team-ramrod/wackyracers/camera_hacking/python/images/test2.jpg

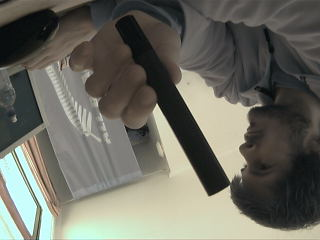
camera_hacking/python/images/test2.jpg
