team-ramrod/wackyracers/camera_hacking/python/images/tree.jpg

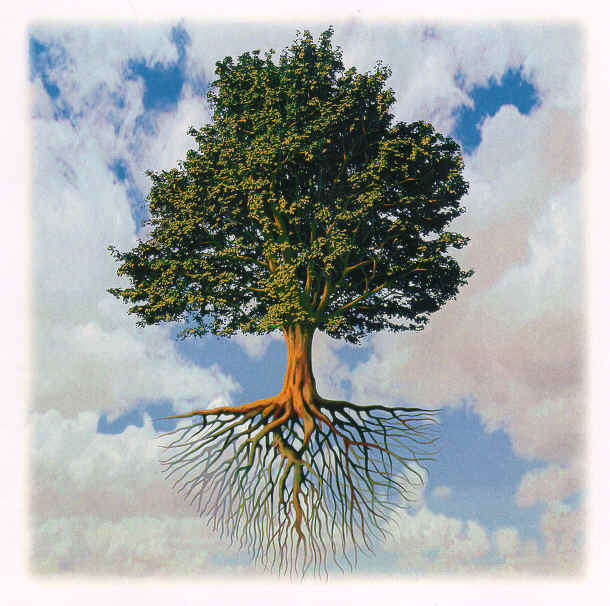
camera_hacking/python/images/tree.jpg
