team-ramrod/wackyracers/README

The preliminary assignment instructions for this assignment are to be found at 
http://ecewiki.elec.canterbury.ac.nz/mediawiki/index.php/ENEL429_project_2011
