team-ramrod/wackyracers/Altium/Perfection.png

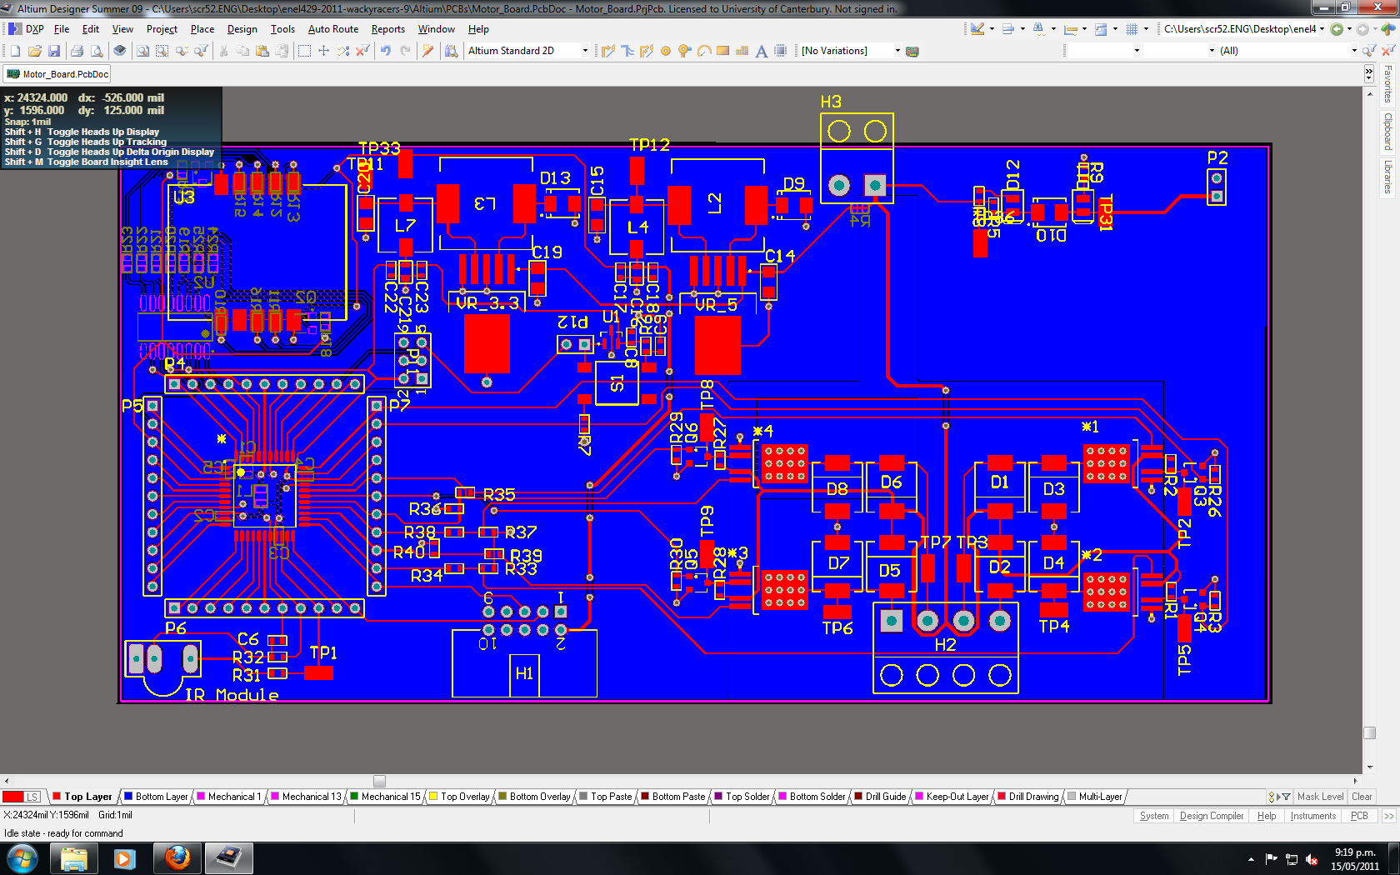
Altium/Perfection.png
