team-ramrod/wackyracers/camera_hacking/python/images/barnes.jpg

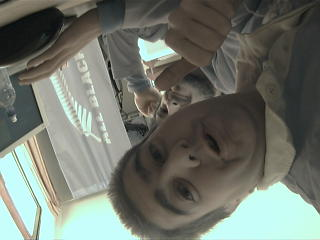
camera_hacking/python/images/barnes.jpg
