team-ramrod/wackyracers/camera_hacking/python/images/new.jpg

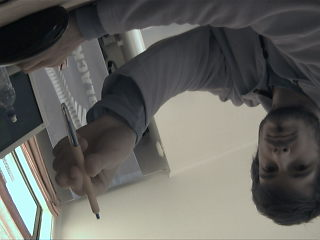
camera_hacking/python/images/new.jpg
