team-ramrod/wackyracers/camera_hacking/python/images/newtest.jpg

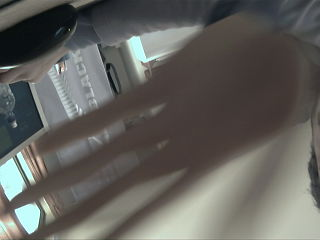
camera_hacking/python/images/newtest.jpg
