team-ramrod/wackyracers/camera_hacking/python/images/out1.jpg

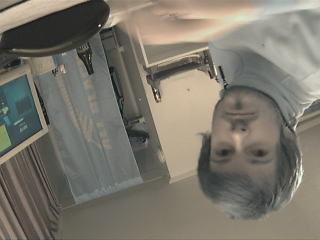
camera_hacking/python/images/out1.jpg
