team-ramrod/wackyracers/camera_hacking/python/images/out.jpg

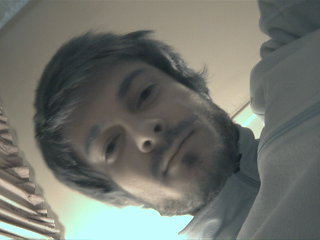
camera_hacking/python/images/out.jpg
