team-ramrod/wackyracers/camera_hacking/python/images/room.jpg

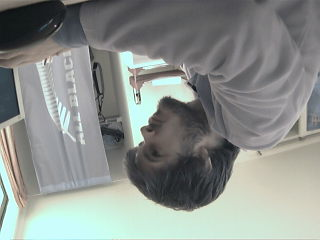
camera_hacking/python/images/room.jpg
