team-ramrod/wackyracers/docs/src/issues.tex

\documentclass[10pt]{article} 

\usepackage{hyperref}

% Muliple rows
\usepackage{multirow}

% Margins
\usepackage[margin=2.5cm]{geometry}

% Uncomment for 1 in margins
%\usepackage[in]{fullpage}

\usepackage[usenames,dvipsnames]{color}

% Font stuff
\usepackage{palatino}

\usepackage{listings}
% Code listings
\lstset{
	language=C, 
    basicstyle=\small\ttfamily,
	keywordstyle=\color{black}\bfseries,
	commentstyle=\color{OliveGreen},
}

\begin{document}
\title{Wacky Racers Issues File}
\author{Daniel Bentall et al.}
\maketitle

\section{Introduction}
This document records issues encountered during development. 

\section{Schematic Issues}
\begin{itemize}
\item The voltage pins are inconsistent and need to be checked through
\item Many non-power pins are drawn as in-out pins (which look like ----$<|>$-) when they should be in or out only
\end{itemize}

\section{PCB Issues}

\section{Software Issues}

\section{Other Issues}

\begin{itemize}
\item Wim
\end{itemize}

\end{document}
