team-ramrod/wackyracers/docs/issues.pdf

# Wacky Racers Issues File

Daniel Bentall et al.

### May 29, 2011

## 1 Introduction

This document records issues encountered during development.

## 2 Schematic Issues

- The voltage pins are inconsistent and need to be checked through
- Many non-power pins are drawn as in-out pins (which look like —-< | >-) when they should be in or
out only

## 3 PCB Issues

## 4 Software Issues

## 5 Other Issues

- Wim

1
