team-ramrod/wackyracers/Altium/Motor_Board.pdf

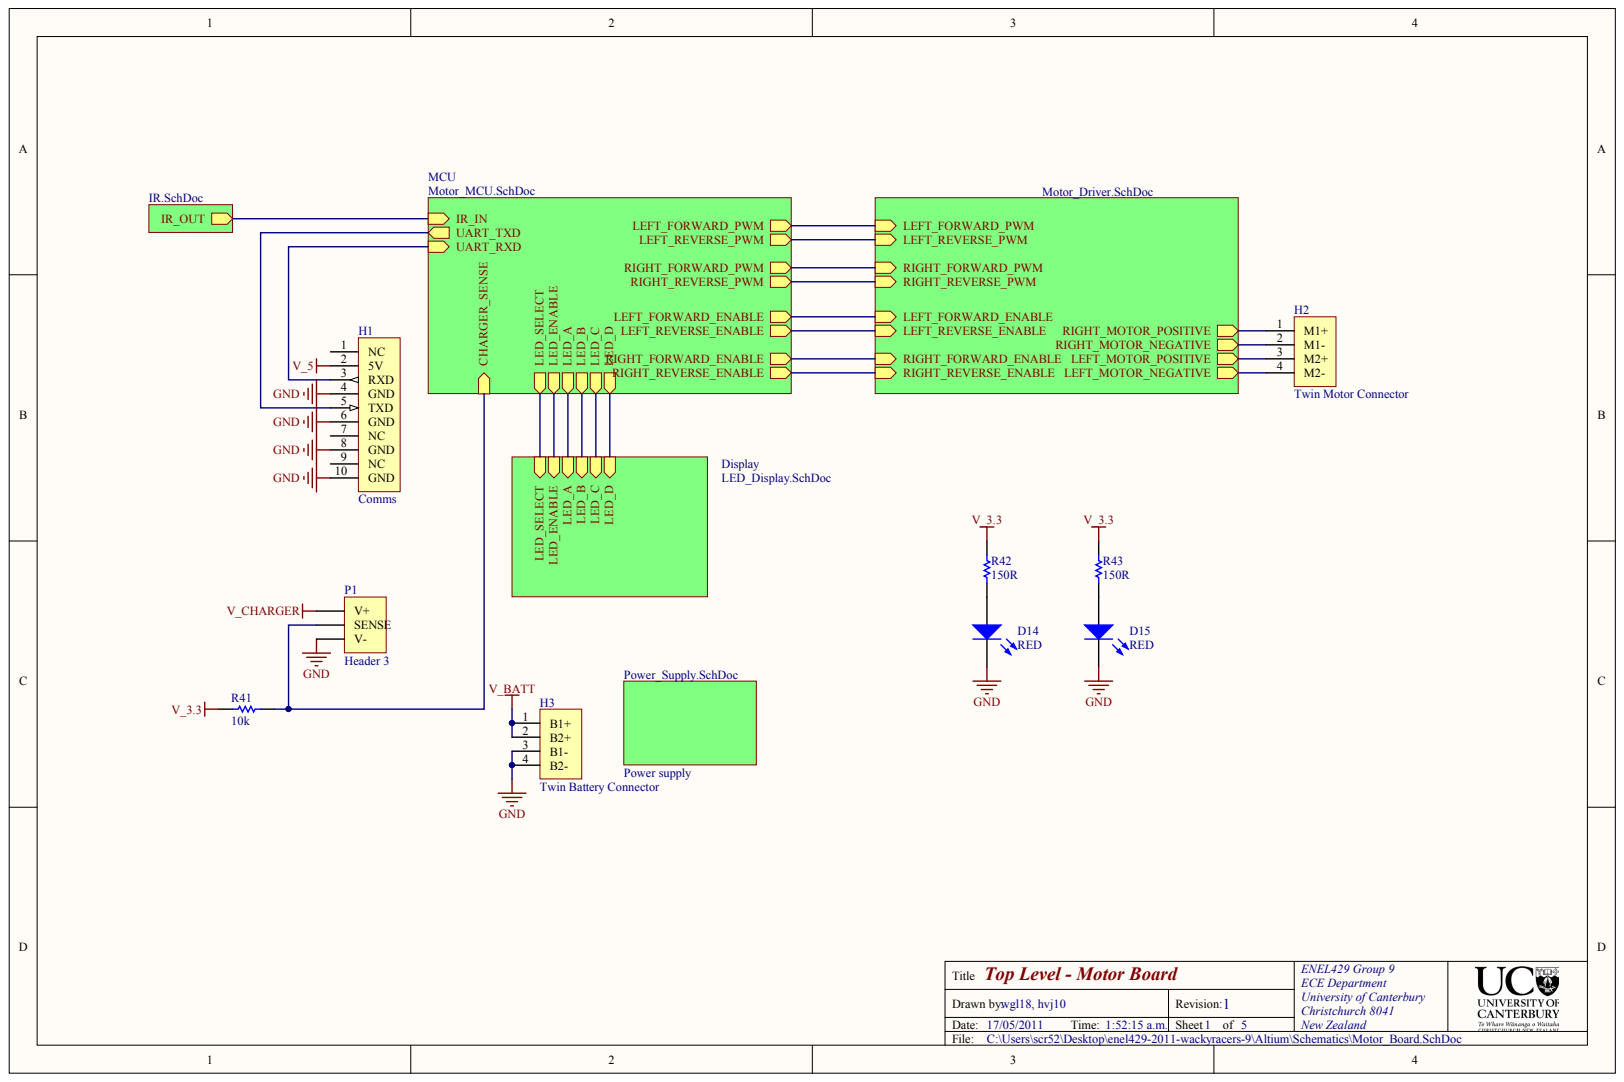
[picture p16: page 1]

4 | GND
5 | TXD
6 | GND NC GND NC GND

Top Level - Motor Board Title | ENEL 429 Group 9 ECE Departmen t University of Canterbury Christchurch 804 1 Ne w Zealan d

Drawn b y : wgl18, hvj1 0 | Re vision : 1

17/05/201 Time: 1:52:15 a.m. | Sheet o f 5

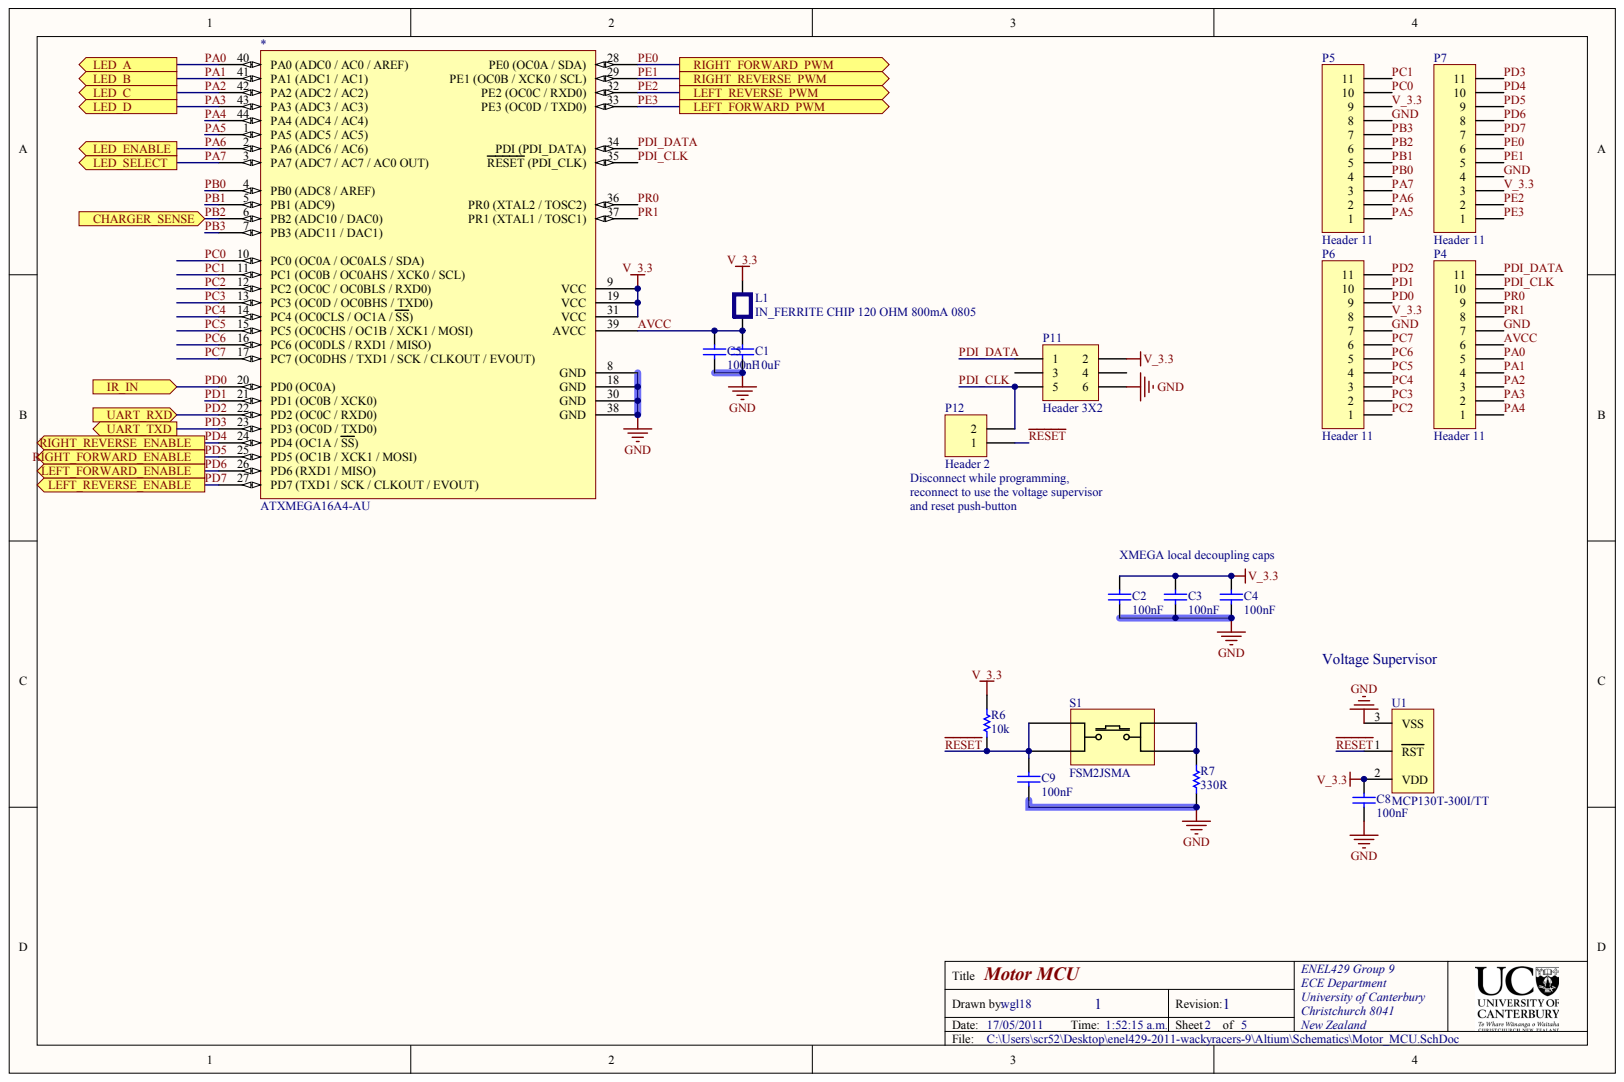
[picture p17: page 2]

Disconnect while programming,
reconnect to use the voltage supervisor
and reset push-button

XMEGA local decoupling caps

Motor MCU Title | ENEL429 Group 9 ECE Department University of Canterbury Christchurch 8041 New Zealand

Drawn by: wgl18 1 | Revision: 1

Date: 17/05/2011 Time: 1:52:15 a.m. | Sheet of 5

C:\Users\scr52\Desktop\enel429-2011-wackyracers-9\Altium\Schematics\Motor_MCU.SchDoc

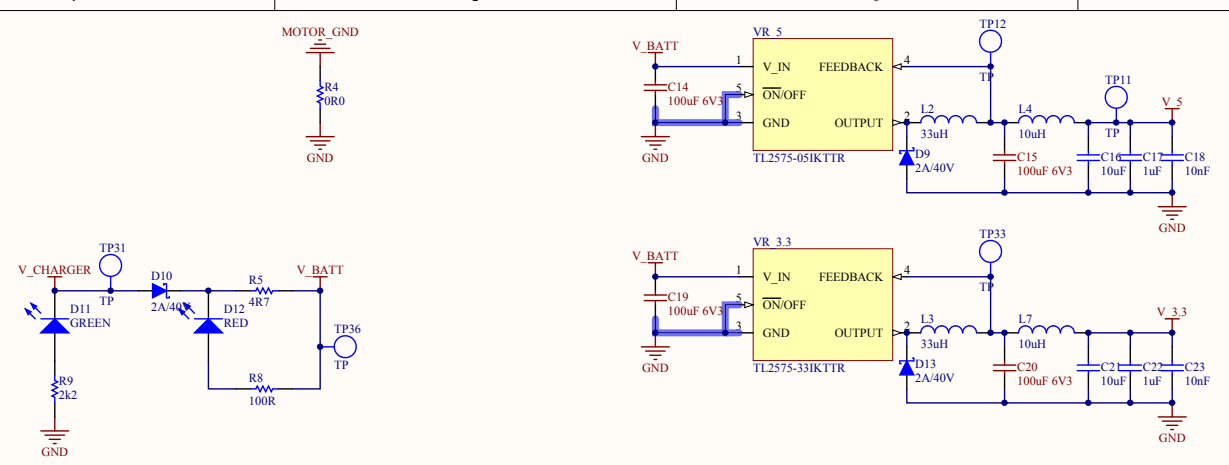
[picture p18: page 3]

Power Supply Title | ENEL 429 Group 9 ECE Departmen t University of Canterbury Christchurch 804 1 Ne w Zealan d

Drawn b y : h vj1 0 | Re vision : 1

17/05/201 Time: 1:52:15 a.m. | Sheet o f 5

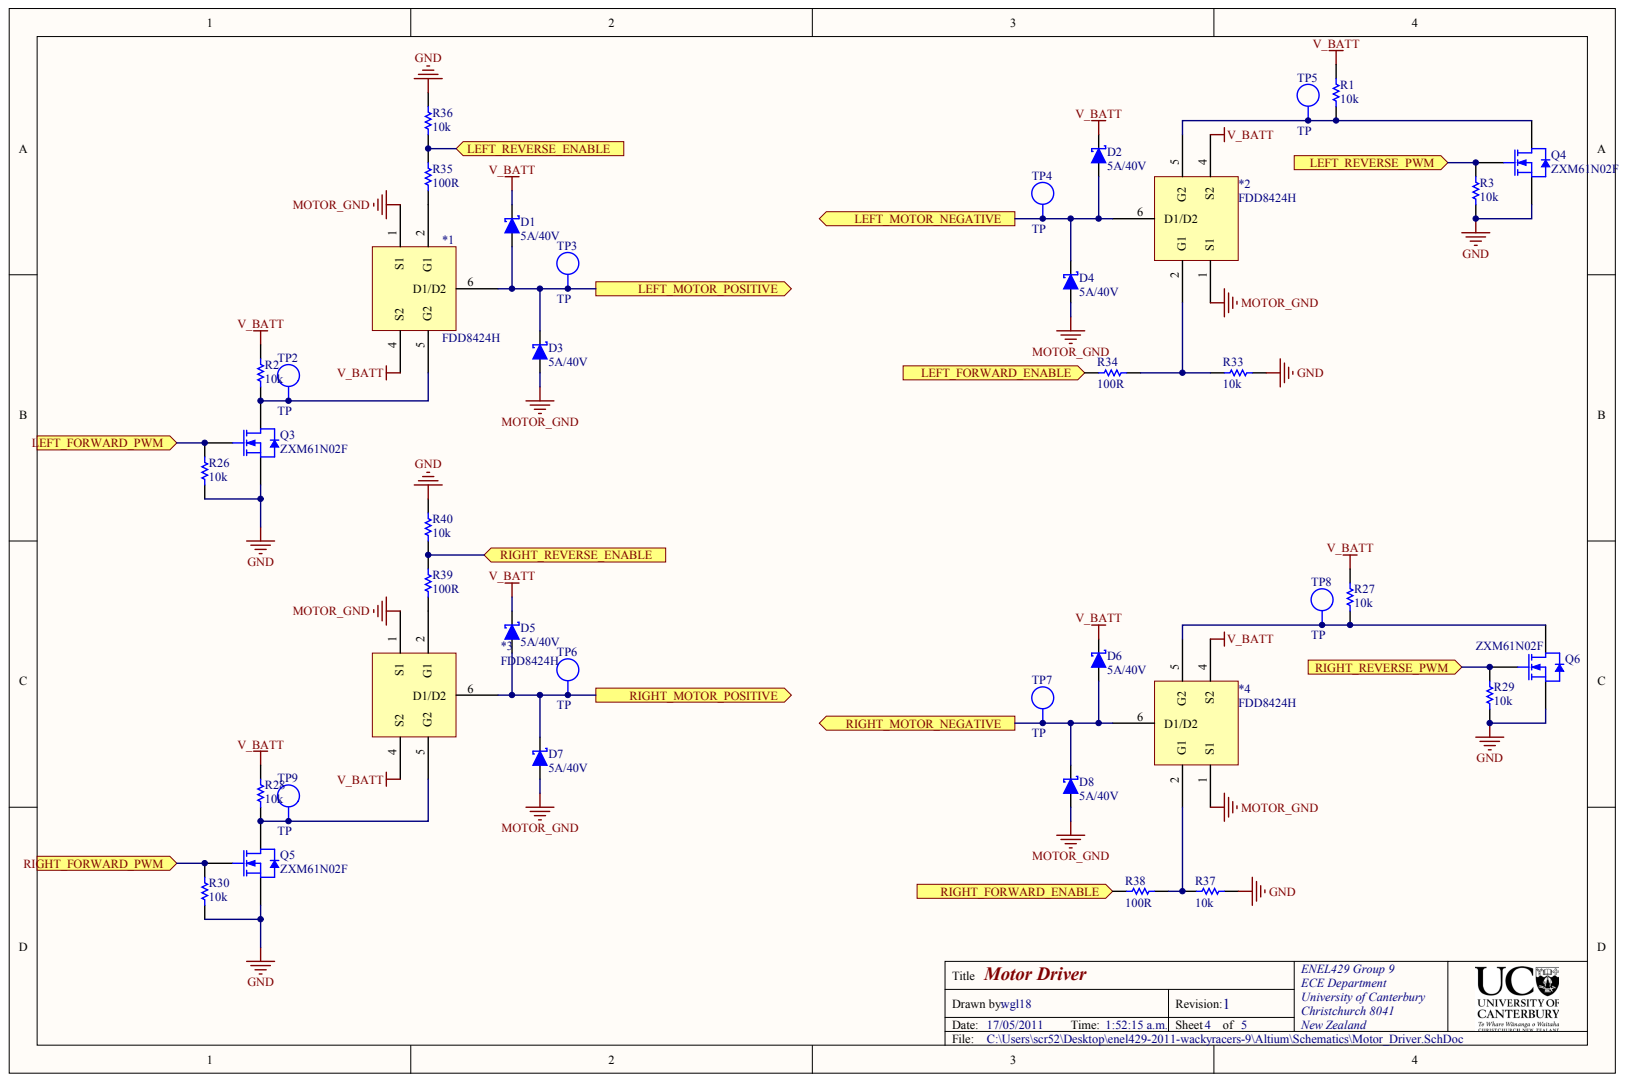
[picture p19: page 4]

Motor Driver Title | ENEL429 Group 9 ECE Department University of Canterbury Christchurch 8041 New Zealand

Drawn by: wgl18 | Revision: 1

C:\Users\scr52\Desktop\enel429-2011-wackyracers-9\Altium\Schematics\Motor_Driver.SchDoc

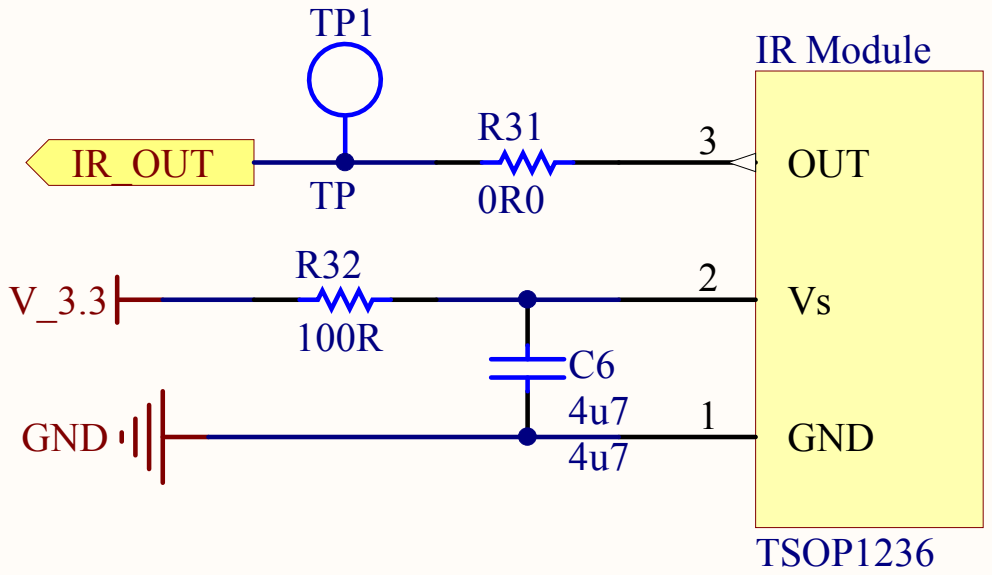
[picture p20: page 5]

IR Module Title | ENEL429 Group 9 ECE Department University of Canterbury Christchurch 8041 New Zealand

Drawn by: djb216 | Revision: 2

C:\Users\scr52\Desktop\enel429-2011-wackyracers-9\Altium\Schematics\IR.SchDoc

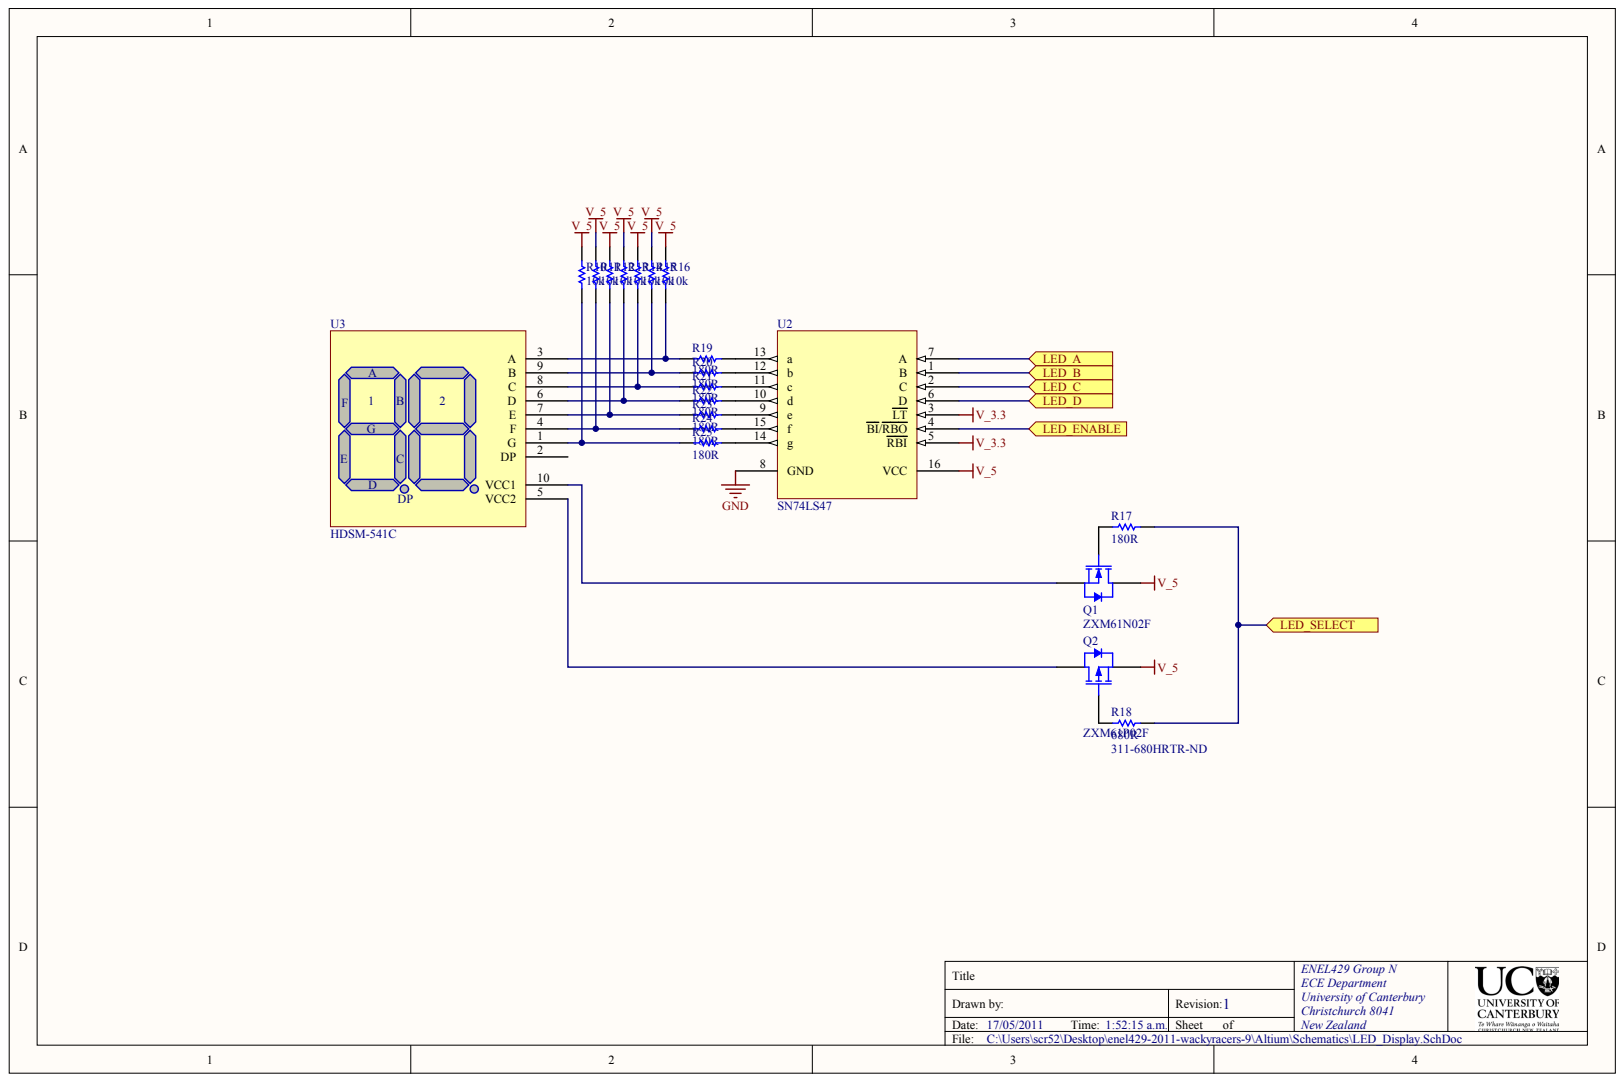
[picture p21: page 6]

Title | ENEL429 Group N ECE Department University of Canterbury Christchurch 8041 New Zealand

Drawn by: | Revision: 1

C:\Users\scr52\Desktop\enel429-2011-wackyracers-9\Altium\Schematics\LED_Display.SchDoc

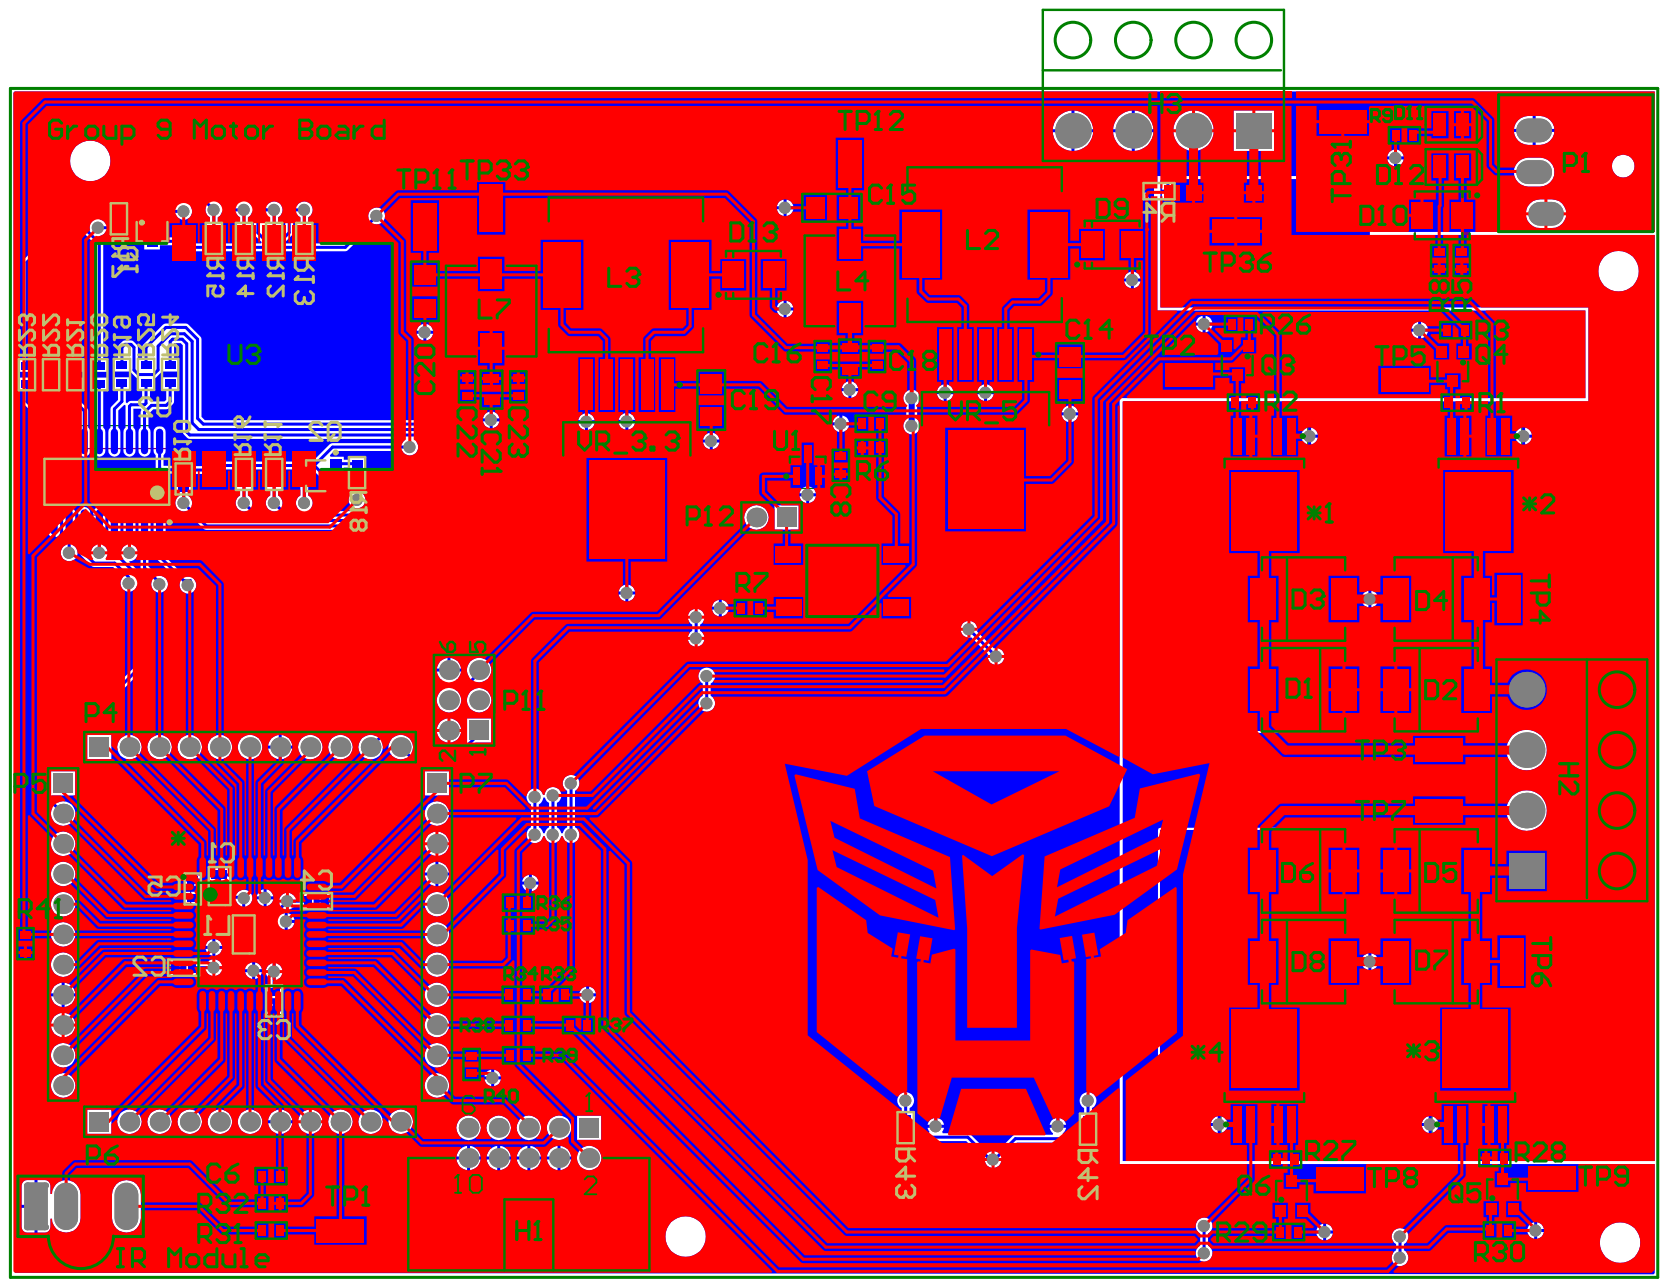
[picture p22: page 7]

Bill of Materials | Top Level - Motor Board
Source Data From: | Motor_Board.PrjPcb
Project: | | Motor_Board.PrjPcb
Variant: | | None
Creation Date: 17/05/2011 | 1:52:45 a.m.
Print Date: | 40680 | 40680.07836
#Column NameComment | #Column Name ErDesignator | Description | Quantity

| | | 1

ATXMEGA16A4-
AU
FDD8424H | *1, *2, *3, *4 | | 4
10uF | C1, C16, C21 | CAP 10uF 10% 10V X5R 0805 | 3
100nF | C2, C3, C4, C5, C8, C9 | CAP CER .10UF 50V X5R 0603 | 6
4u7 | C6 | CAP CER 4.7UF 10V X5R 0603 | 1
100uF 6V3 | C14, C15, C19, C20 | 100uF 6.3V 1206 multi-layer ceramic
| | capacitor | 4
1uF | C17, C22 | CAP CER 1.0UF 50V X7R 0603 | 2
10nF | C18, C23 | CAP CER 10000PF 100V X7R 0603 | 2
5A/40V | D1, D2, D3, D4, D5, D6, D7, D8 | DIODE SCHOTTKY 5A 40V SMC | 8
2A/40V | D9, D10, D13 | Schottky Diode - 2A/30V | 3
LED Green | D11 | Green LED 0805 | 1
LED Red | D12, D14, D15 | Red LED 0805 | 3
Comms | H1 | Header, IDC 10-Pin | 1
Twin Motor Connector | H2 | 5.08mm Pluggable Terminal Header | 1
Twin Battery Connector | H3 | 5.08mm Pluggable Terminal Header | 1
TSOP1236 | IR Module | | 1
IN_FERRITE CHIP 120 OHM 800mA 0805 | L1 | FERRITE CHIP 120 OHM 800mA 0805 | 1
Inductor | L2, L3 | INDUCTOR POWER SHIELD 33UH 2.6A
| | SMD | 2
10uH | L4, L7 | INDUCTOR POWER 10UH 2.0A SMD | 2
Header 3 | P1 | Header, 3-Pin | 1
Header 11 | P4, P5, P6, P7 | Header, 11-Pin | 4
Header 3X2 | P11 | Header, 3-Pin, Dual row | 1
Header 2 | P12 | Header, 2-Pin | 1
ZXM61N02F | Q1, Q3, Q4, Q5, Q6 | 20V N-channel enhancement mode
| | MOSFET | 5
ZXM61P02F | Q2 | 20V P-channel enhancement mode
| | MOSFET | 1
10k | R1, R2, R3, R6, R10, R11, R12, R13,
| R14, R15, R16, R26, R27, R28, R29, R30,
| R33, R36, R37, R40, R41 | RES 10.0K OHM 1/10W 1% 0603 SMD | 21
4R7 | R5 | RES 4.7R 1/10W 5% 0603 SMD | 1
330R | R7 | RES 330 OHM 1/10W 1% 0603 SMD | 1
100R | R8, R32, R34, R35, R38, R39 | RES 100 OHM 1/10W 1% 0603 SMD | 6
2k2 | R9 | RES 2.2K OHM 1/10W 5% 0603 SMD | 1
180R | R17, R19, R20, R21, R22, R23, R24, R25 | RES 180OHM 1/10W 1% 0603 SMD | 8
680R | R18 | RES 680 OHM 1/10W 1% 0603 SMD | 1
150R | R42, R43 | RES 150 OHM 1/10W 1% 0603 SMD | 2
FSM2JSMA | S1 | DPST SMD Switch | 1
MCP130T- 300I/TT | U1 | Microcontroller Supervisory Circuit with
| | Open Drain Output, 3-Pin SOT-23,
| | Industrial Temperature, Tape and Reel | 1
SN74LS47 | U2 | SN74LS47 | 1
HDSM-541C | U3 | 2 character 7 segment display | 1
TL2575-33IKTTR | VR_3.3 | | 1
TL2575-05IKTTR | VR_5 | | 1
| | | 107
Approved | Notes
