team-ramrod/wackyracers/(list of files, drawings)

Other design files:
Altium/Camera_Board.PrjPcb
Altium/Motor_Board.PrjPcb
Altium/PCBs/Camera_Board.PcbDoc
Altium/PCBs/Motor_Board.PcbDoc
Altium/Schematics/Bluetooth.SchDoc
Altium/Schematics/Camera.SchDoc
Altium/Schematics/Camera_Board.SchDoc
Altium/Schematics/Camera_LED_Display.SchDoc
Altium/Schematics/Camera_MCU.SchDoc
Altium/Schematics/IR.SchDoc
Altium/Schematics/LED_Display.SchDoc
Altium/Schematics/Motor_Board.SchDoc
Altium/Schematics/Motor_Driver.SchDoc
Altium/Schematics/Motor_MCU.SchDoc
Altium/Schematics/Power_Supply.SchDoc
Altium/Wacky_Init.PrjPcb
