team-ramrod/wackyracers/src/uart_common.h

#ifndef UART_COMMON_H
#define UART_COMMON_H

#include <stdio.h>
#include <avr/io.h>
#include <avr/interrupt.h>

// Interrupt for data from the debug port.
#define INTERRUPT_DEBUG USARTC1_RXC_vect

FILE stream_debug[1];
FILE stream_board[1];

#endif /* UART_COMMON_H */
