team-ramrod/wackyracers/(commit log)

2011-03-18 Added AT91SAM7S_demo1
    [AT91.SchDoc, AT91SAM7S_Demo1.PrjPcb, Communications.SchDoc, Power.SchDoc, TopLevel.SchDoc, Treetap7c.PcbLib, Treetap7c.SCHLIB, UserInterface.SchDoc]
2011-03-24 Added TopLevel
    [Top_level_20111.SchDoc, Wacky_1.PcbLib, Wacky_1.SchLib, Wacky_Init.PrjPcb]
2011-04-13 Added the Power_Supply to the top level
    [Power_Supply.SchDoc, Top_level_20111.SchDoc, Wacky_Init.PrjPcb]
2011-04-16 Added motor driver and fixed up svn:ignore for the Altium stuff.
    [Motor_Driver.SchDoc, Top_level_20111.SchDoc]
2011-04-17 Added the schematics to the project file
    [Wacky_Init.PrjPcb]
2011-04-17 Separated up all the schematics and added to the project file
    [Bluetooth.SchDoc, Camera.SchDoc, Camera_Board.SchDoc, IR.SchDoc, Motor_Board.SchDoc, Top_level_20111.SchDoc, Wacky_Init.PrjPcb]
2011-04-17 Created IR PCB Footprint
    [Wacky_1.PcbLib]
2011-04-17 Added xmega component schematic.
    [Wacky_1.SchLib]
2011-04-17 Added the MC33886VW motor driver footprint.
    [Wacky_1.PcbLib]
2011-04-17 Added IR receiver schematic
    [Wacky_1.SchLib]
2011-04-17 Added IR chip and connectors
    [IR.SchDoc]
2011-04-17 Added schematic component for MC33886VW.
    [Wacky_1.SchLib]
2011-04-17 Added IR to Motor board
    [Motor_Board.SchDoc]
2011-04-17 Fixed my cock-up.
    [Wacky_1.PcbLib]
2011-04-17 Scaled IR module
    [Wacky_1.SchLib]
2011-04-17 Added footprint for MAX3001EEUP to the PCB library
    [Wacky_1.PcbLib]
2011-04-17 Added the power supply component the TI2575
    [Wacky_1.SchLib]
2011-04-17 Added the MAX3001EEUP schematic to the library.
    [Wacky_1.SchLib]
2011-04-17 camera connections
    [Camera.SchDoc, Camera_Board.SchDoc]
2011-04-17 Updated the motor driver sheet
    [Motor_Driver.SchDoc]
2011-04-17 Updated the motor board for the new motor driver.
    [Motor_Board.SchDoc]
2011-04-17 Renamed the top level folder
    [Bluetooth.SchDoc, Camera.SchDoc, Camera_Board.SchDoc, Dwl-Altium-PCB-Footprint-Library.PcbLib, Dwl-Altium-Schematic-Symbol-Library.SchLib, IR.SchDoc, Motor_Board.SchDoc, Motor_Driver.SchDoc]
2011-04-17 Updated the motor driver
    [Motor_Driver.SchDoc]
2011-04-17 Added the power component
    [Wacky_1.PcbLib]
2011-04-17 camera level conversion
    [Camera.SchDoc]
2011-04-17 Updated motor driver, nigh final.
    [Motor_Driver.SchDoc]
2011-04-17 fixed Bluetooth.SchDoc and got rid of Bluetooth_might_crash_altium.SchDoc
    [Bluetooth.SchDoc, Bluetooth_might_crash_altium.SchDoc]
2011-04-19 Added the voltage regulator datasheet
2011-04-19 Fixed component in lib and power supply circuit
    [Power_Supply.SchDoc, Wacky_1.SchLib]
2011-04-19 Started on the local bypass capacitors and protection diodes.
    [Motor_Driver.SchDoc]
2011-04-19 Added test points to camera board.
    [Camera.SchDoc, Camera_Board.SchDoc]
2011-04-19 Fixed shitq
    [Motor_Board.SchDoc, Power_Supply.SchDoc]
2011-04-19 Updated the voltage level changer component layout.
    [Wacky_1.SchLib]
2011-04-19 XMEGA pins rearranged
    [Wacky_1.SchLib]
2011-04-19 Tidy up after level shifter footprint changed.
    [Camera.SchDoc]
2011-04-19 Updating the motor driver component
    [Wacky_1.SchLib]
2011-04-19 spaced mcu
    [Wacky_1.SchLib]
2011-04-19 Hopefully finished the motor driver now.
    [Motor_Driver.SchDoc]
2011-04-19 Added charging circuit to the power supply schematic
    [Power_Supply.SchDoc]
2011-04-19 Added a better xmega schematic component.
    [Wacky_1.SchLib]
2011-04-19 Changed xmega width
    [Wacky_1.SchLib]
2011-04-19 Started on the motor driver mcu
    [Motor_Board.SchDoc]
2011-04-19 Added nets to all the motor driver mcu pins.
    [Motor_Board.SchDoc, Motor_Driver.SchDoc]
2011-04-19 Added line
    [Motor_Board.SchDoc]
2011-04-20 Updating the mcu component. Don't worry, the pins haven't moved this time.
    [Wacky_1.SchLib]
2011-04-20 Got rid of bus and tidied up motor board
    [Motor_Board.SchDoc]
2011-04-20 Updated inputs and outputs for voltage regulators
    [Wacky_1.SchLib]
2011-04-20 Updated the motor board.
    [Motor_Board.SchDoc]
2011-04-20 Added notes on the timers.
2011-04-20 Last change.
    [Motor_Board.SchDoc]
2011-04-20 Added test points
    [Power_Supply.SchDoc]
2011-04-20 Updated numbers and added pullup resistor to the level changer.
    [Motor_Driver.SchDoc]
2011-04-20 Updated for submission
    [Bluetooth.SchDoc, Camera.SchDoc]
2011-04-20 Added test point
    [IR.SchDoc]
2011-04-20 Added the hand in schematic
2011-04-21 Testing Altium 9.4 for forwards compatibility.
    [9.4 test - please tell Simon if you can open this with 9.3 (the uni version).SchDoc]
2011-04-24 Fixed the line endings and added a ruby script to do it automagically
    [camera.c, camera.h, common.h, main-cam.c, main-motor.c, main.c]
2011-04-26 I could open it.
    [9.4 test - I could open it at Uni.SchDoc]
2011-04-27 Added a couple of XMEGA application notes.
2011-04-27 Updated Motor Board.
    Added voltage supervisor.
    Added reset push button.
    Added PDI programming port.
    [Motor_Board.SchDoc]
2011-04-27 Touched some stuff up
    [Motor_Board.SchDoc]
2011-04-28 Working build of the motors
2011-04-28 9.4 tested and is compatible.
    [9.4 test - I could open it at Uni.SchDoc]
2011-04-29 Split project in two.
    [Camera_Board.PrjPcb, Motor_Board.PrjPcb]
2011-04-29 Cleaned up the Altium folder.
    SVN really doesn't like to move stuff though, hopefully I've got all the right versions of the files now.
    [Bluetooth.SchDoc, Camera.SchDoc, Camera_Board.PcbDoc, Camera_Board.PrjPcb, Camera_Board.SchDoc, IR.SchDoc, Motor_Board.PcbDoc, Motor_Board.PrjPcb]
2011-04-29 Renaming motor's gnd and battery input voltage
    [Motor_Driver.SchDoc, Power_Supply.SchDoc]
2011-04-29 Fixing some of the problems
    [Motor_Driver.SchDoc, Power_Supply.SchDoc]
2011-04-29 Added programming port, voltage supervisor and reset button to camera board.
    [Camera_Board.SchDoc, Motor_Board.SchDoc]
2011-04-29 Updated all the component designators for motor board.
    Simply open the schematic annotator, select reset duplicates then update changes list to remove duplicate designators.
    [Motor_Board.PrjPcb, Motor_Board.SchDoc, Motor_Driver.SchDoc, Power_Supply.SchDoc]
2011-04-29 Not sure what Henry was doing with those voltage regulators. Fixed so V_in and on/off are connected the right way around.
    [Power_Supply.SchDoc]
2011-04-29 Updated resistor and capacitor to the other component library
    [IR.SchDoc]
2011-04-29 Moved stuff around to stop Altium complaints.
    [Motor_Board.SchDoc, Power_Supply.SchDoc]
2011-04-29 Fixed the TL2575 schematic
    [Power_Supply.SchDoc]
2011-04-29 Something changed.
    [Motor_Board.PrjPcb]
2011-05-02 MOAR TESTPOINTS!!!
    [Motor_Driver.SchDoc]
2011-05-03 Made new pdfs of the schematics
2011-05-05 Added title block to the power supply sheet
    [Power_Supply.SchDoc]
2011-05-05 Added the manufacturer and supplier info to the schematic libraries.
2011-05-06 * Seperated the motor mcu to a separate schematic. * Added fault status and disable i/o to motor driver so we can actually reset the motor drivers * Updated Motor Driver to use all ENEL429_3 componen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
    [Motor_Board.PrjPcb, Motor_Board.SchDoc, Motor_Driver.SchDoc, Motor_MCU.SchDoc, Power_Supply.SchDoc]
2011-05-06 Really wish altium would automatically save the project....
    [Motor_Board.PrjPcb]
2011-05-06 Fixed the MC33886 schematic
    [Motor_Driver.SchDoc]
2011-05-06 Fixing some ERC problems
    [Motor_Board.PrjPcb, Motor_Driver.SchDoc]
2011-05-06 Changed the motor mcu to use enel429_3 components
    [Motor_Board.PrjPcb, Motor_MCU.SchDoc]
2011-05-06 Changed most headers, just need the charger one still.
    [Motor_Board.SchDoc]
2011-05-06 Updated the motor board to the template.
    [IR.SchDoc, Motor_Board.SchDoc, Motor_Driver.SchDoc, Motor_MCU.SchDoc, Power_Supply.SchDoc]
2011-05-06 Updated motor board pdf
    [Motor_Board.PrjPcb]
2011-05-06 Imported the huntsbury rules into both pcb documents.
    [Camera_Board.PcbDoc, Motor_Board.PcbDoc]
2011-05-06 Linked footprint for vr's
2011-05-06 Updated power supply to use the proper components
    [Motor_Board.PrjPcb, Motor_Board.SchDoc, Power_Supply.SchDoc]
2011-05-06 Work on the motor board PCB, mainly the motor driver stuff.
    [Motor_Board.PcbDoc, Motor_Board.SchDoc, Motor_Driver.SchDoc, Power_Supply.SchDoc]
2011-05-06 Missed files
    [Motor_Board.PrjPcb, Power_Supply.SchDoc]
2011-05-07 Lots of changes, motor board PCB is mostly done, just needs some small connector changes and part replacements for the IR.
    [Motor_Board.PcbDoc, Motor_Board.SchDoc, Motor_Driver.SchDoc, Motor_MCU.SchDoc, Power_Supply.SchDoc]
2011-05-08 Some more work on the Motor PCB.
    [Motor_Board.PcbDoc, Motor_Board.PrjPcb, Power_Supply.SchDoc]
2011-05-08 Split camera board into sub schematics, esp, MCU
    [Camera_Board.SchDoc, Camera_MCU.SchDoc]
2011-05-08 Started the 2 char 7 segment component
    [Motor_MCU.SchDoc]
2011-05-08 Tidy up and added test points. Swapped the Maxim level shifter for a smaller TI one.
    [Camera.SchDoc, Camera_Board.SchDoc]
2011-05-08 Added footprint for the HDSP-521E 7 segment display.
2011-05-08 Started on the error display
    [Motor_Board.PcbDoc, Motor_Board.PrjPcb, Motor_MCU.SchDoc]
2011-05-09 Updating the makefile and motor controller
2011-05-09 Added led driver datasheet
2011-05-09 Updated the led driver component
2011-05-09 Added files to Camera_Board.PrjPcb
    [Camera_Board.PrjPcb]
2011-05-09 Updated LED Display
    [LED_Display.SchDoc, Motor_Board.SchDoc, Motor_MCU.SchDoc]
2011-05-09 Missed the project of course
    [Motor_Board.PrjPcb]
2011-05-09 Tidy up
    [Bluetooth.SchDoc, Camera.SchDoc, Camera_Board.SchDoc, Camera_MCU.SchDoc]
2011-05-09 Added LED display to PCB
    [LED_Display.SchDoc, Motor_Board.PcbDoc]
2011-05-10 changed name block of bluetooth and camera board
    [Bluetooth.SchDoc, Camera_Board.SchDoc]
2011-05-10 minor changes to maera board and bluetooth
    [Bluetooth.SchDoc, Camera_MCU.SchDoc]
2011-05-10 added drawing numbers
    [Bluetooth.SchDoc, Camera.SchDoc, Camera_Board.SchDoc]
2011-05-10 Changed IR receiver from TSOP38236 to TSOP1236
    [IR.SchDoc]
2011-05-10 Added 0 ohm inline resistor to IR Schematic
    [IR.SchDoc]
2011-05-10 Fixing neck down constraint
    [Motor_Board.PcbDoc]
2011-05-10 Changed all components to ENEL429_3 (excluding ones which were already wacky_1 or misc connectors)
    [Bluetooth.SchDoc, Camera.SchDoc, Camera_Board.SchDoc, Camera_MCU.SchDoc, IR.SchDoc]
2011-05-10 Added capacitors to camera board VREG
    [Bluetooth.SchDoc, Camera_Board.PrjPcb, Camera_Board.SchDoc, Camera_MCU.SchDoc]
2011-05-10 Grounded unused pins and set direction of TXD RXD
    [Camera.SchDoc]
2011-05-10 Datasheet for dual mosfet
2011-05-10 Added the LED display to camera board and updated names for Motor board
    [Camera_Board.SchDoc, Motor_MCU.SchDoc]
2011-05-10 Updated ports on the Camera_MCU.SchDoc
    [Camera_Board.PrjPcb, Camera_LED_Display.SchDoc, Camera_MCU.SchDoc]
2011-05-10 Added PE2 and PE3 net labels to MCU
    [Camera_MCU.SchDoc]
2011-05-10 Made cosmetic changes
    [Camera_Board.PrjPcb, Camera_LED_Display.SchDoc, LED_Display.SchDoc]
2011-05-10 I don't even....
    [Motor_Board.SchDoc, Motor_Driver.SchDoc, Motor_MCU.SchDoc, Power_Supply.SchDoc]
2011-05-11 Added supplier info for h-bridge chip. updated all components so they will have latest info.
    [IR.SchDoc, LED_Display.SchDoc, Motor_Board.PrjPcb, Motor_Board.SchDoc, Motor_Driver.SchDoc, Motor_MCU.SchDoc, Power_Supply.SchDoc]
2011-05-11 Updated to use ENEL429_4.
    [IR.SchDoc, LED_Display.SchDoc, Motor_Board.PrjPcb, Motor_Board.SchDoc, Motor_Driver.SchDoc, Motor_MCU.SchDoc, Power_Supply.SchDoc]
2011-05-11 Changed the green LED footprint
    [Power_Supply.SchDoc]
2011-05-11 Completely changed the motor driver again.
    [Motor_Board.PcbDoc, Motor_Driver.SchDoc]
2011-05-11 Added TODO - a list of tasks remaining for the schematic
2011-05-11 fixed 3 items on todo list
    [Camera_MCU.SchDoc, Motor_Board.PrjPcb, Power_Supply.SchDoc]
2011-05-11 Fixed power net names.
    [Camera_Board.SchDoc, Camera_LED_Display.SchDoc, Camera_MCU.SchDoc]
2011-05-14 Added extra pins for the motor driver to the MCU.
    [Motor_Board.SchDoc, Motor_MCU.SchDoc]
2011-05-14 Work on the motor driver.
    [Motor_Board.PcbDoc, Motor_Driver.SchDoc]
2011-05-15 started camera schematic
    [Bluetooth.SchDoc, Camera.SchDoc, Camera_Board.PcbDoc, Camera_Board.SchDoc, Camera_LED_Display.SchDoc, Camera_MCU.SchDoc]
2011-05-15 did pcb led display for camera board
    [Camera_Board.PcbDoc, Camera_LED_Display.SchDoc]
2011-05-15 everything on camera pcb apart from power and ground hooked up
    [Bluetooth.SchDoc, Camera.SchDoc, Camera_Board.PcbDoc]
2011-05-15 Camera board almost complete.
    [IR.SchDoc, Motor_Board.PcbDoc, Motor_Driver.SchDoc, Motor_MCU.SchDoc, Power_Supply.SchDoc]
2011-05-15 Motor board almost complete, also: Ignore my last message, I never worked on the camera board.
    [Motor_Board.PcbDoc]
2011-05-15 Motor_Board.PcbDoc compiles without errors/warnings.
    [Motor_Board.PcbDoc, Motor_Board.PrjPcb]
2011-05-15 Halfway thru redesign.
    [Motor_Board.PcbDoc, Motor_MCU.SchDoc]
2011-05-15 Mostly connected.
    [Camera_Board.PcbDoc, Camera_Board.PrjPcb, Camera_MCU.SchDoc]
2011-05-15 Good night.
    [Motor_Board.PcbDoc]
2011-05-15 Fixed the motor driver, really needs checking by at least two other people. Hopefully won't blow up our b82rez now.
    [Motor_Driver.SchDoc]
2011-05-15 worked on camera pcb. fixed all errors except ones that mean altering the ground plane
    [Camera_Board.PcbDoc, Camera_Board.PrjPcb]
2011-05-15 Getting there.
    [Motor_Board.PcbDoc]
2011-05-15 Added Optimus.
    [Motor_Board.PcbDoc]
2011-05-16 Getting there, issues: Some vias may be incorrectly sized; 0Ohm resistor might not be placed correctly, battery jumper needs replacement, lead going form battery jumper to cpu crosses motor ground pl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
    [Camera_Board.PrjPcb, Motor_Board.PcbDoc, Motor_Board.PrjPcb]
2011-05-16 camera board now warning and error free
    [Camera_Board.PcbDoc]
2011-05-16 added silly logo
    [Camera_Board.PcbDoc]
2011-05-16 will need someone to look over it but i think camera board is pretty much done
    [Camera_Board.PcbDoc, Camera_Board.PrjPcb]
2011-05-16 Nearly done, gotta go but I'll be back later tonight if anyone actually reads this.
    [Motor_Board.PcbDoc, Motor_Board.PrjPcb, Motor_MCU.SchDoc]
2011-05-16 All except one error done.
    [Motor_Board.PcbDoc]
2011-05-16 0 errors, hopefully the right size
    [Motor_Board.PcbDoc]
2011-05-16 added top vcc plane and silk screen. removed ground and 3.3v test points
    [Bluetooth.SchDoc, Camera.SchDoc, Camera_Board.PcbDoc]
2011-05-16 Done waiting on the charger connector
    [Motor_Board.PcbDoc, Motor_Board.PrjPcb, Motor_Board.SchDoc]
2011-05-16 glowing robot eyes
    [Camera_Board.PcbDoc, Camera_Board.SchDoc]
2011-05-16 tiny change to spelling on silk screen
    [Camera_Board.PcbDoc]
2011-05-16 Manual merge FTW!!!!!
    [Motor_Board.PcbDoc, Motor_Board.SchDoc]
2011-05-16 iv said it multiple times but camera board done
    [Camera_Board.PcbDoc, Camera_Board.PrjPcb]
2011-05-16 Pdfs generated
    [Camera_Board.PrjPcb, Motor_Board.PrjPcb, Motor_Board.SchDoc]
2011-05-16 Yeah dog, 52 violations fixed boy! Updated the pdf's too.
    [Camera_Board.PcbDoc, Motor_Board.PcbDoc]
2011-05-16 B:LLALLSKJDASLKDASDL:KASD:LKNADSNKL:JASDKNL:ASD Balls
    [Camera_Board.PcbDoc, Motor_Board.PcbDoc]
2011-05-16 I WARNED YOU ABOUT STAIRS BRO!!!! I TOLD YOU DOG!
    [Motor_Board.PcbDoc]
2011-05-27 uart and cmd headers
2011-05-27 renamed usart to uart
2011-05-27 Fixed the wrong enum name.
    [common.h]
2011-05-27 Updated motor header and the svn:ignore
2011-05-29 Some work on the motor stuff. Nope, definitely not using enums for indexing simon
2011-05-30 Some more work on the motor stuff
2011-05-30 Updated motor, added gnu99 to CFLAGS so that util/atomic can be used
2011-05-30 Added a start on the led header file
2011-05-30 Added in a minimal ir header and empty implementations of led and ir
2011-05-30 Cleaned up Makefile and commented out uart.c since it breaks the build
2011-05-30 Moving MOTOR_TC definition to common.h
2011-05-30 Fixing which TC the motor uses
    [common.h]
2011-05-30 Fixing the TC defines for the motor driver again and adding the led TC define.
    [common.h]
2011-05-30 Added LED implementation
2011-05-30 Using the interrupt stuff
2011-05-30 Making it non-blocking since it doesn't matter if the LEDs switch a little slow
    [led.c]
2011-05-30 Added a *catch-all* interrupt handler in case something goes wrong.
    [main-motor.c]
2011-05-30 Added actual interrupt enabling
2011-05-30 Made motor_set_direction non-reentrant instead of just purely blocking, probably an abuse of the word reentrant
2011-05-31 Added a camera hacking scratchpad folder.
2011-06-01 It now works when only writing the device.
2011-06-01 We're now getting properly synced frames... took a while
2011-06-01 Added start of the motor controller
2011-06-02 deleting old uarts
2011-06-02 changed uart_cam to main uart
2011-06-02 unfucked uart
2011-06-02 Added debug UART stuff
2011-06-02 Started on IR, reserved a timer in common.h
2011-06-02 something weird going on with uart will fix later
    [main-cam.c]
2011-06-02 fixed uart files
2011-06-02 re-added charger to make file
2011-06-02 added bluetooth getting camera data
2011-06-03 Updated for hte new LED display format
2011-06-03 Programmed motor board successfully, camera board failed
    [led.h, main-cam.c, main-motor.c]
2011-06-04 Completed the state machine for the motor board as described by wim.
2011-06-05 uart now compiles
2011-06-06 Fixed all the build errors
    [charger.c, ir.c]
2011-06-06 Halfway through getting the uart code compiling.
2011-06-06 Uart update.
2011-06-06 uart replaced with existing driver, test added too. Also test target added to Makefile (don't hurt me).
2011-06-06 Added an init function to switch to 32MHz clock
2011-06-06 Updated test to display on the LED's
2011-06-06 Fixed the clock init
    [clock.h]
2011-06-06 Changed led_display to be decimal
2011-06-06 Cleaning up motor.h
2011-06-06 Tested the actual delay time for the motors
2011-06-08 Fixed wrong datatype for motor speed
2011-06-08 Added a motor test
2011-06-09 changed bluetooth to work with new uart. Have done the interrupts incorrectly though
2011-06-09 Added charger header for henry
2011-06-09 edited test usart to test board
2011-06-09 Updated the charger header
2011-06-09 Added initial button code
2011-06-09 Fixed the PWM defines
2011-06-09 slowed the motor pwm down
2011-06-09 new motor test code
2011-06-09 Added charger code and makefile config for it
2011-06-10 Some uart code
2011-06-10 uart test code
2011-06-10 working button polling - wgl18
2011-06-10 uart test displays on board whatever number you enter
2011-06-10 got a baisc uart interrupt working
2011-06-12 finished uart interface to bluetooth
2011-06-23 Moved led test file Added a default to the motor controler main switch statement
2011-06-23 fixed it so uart works again
    [motor_test.c]
2011-06-23 Fixed incorrect pins used by the uart for motor board
    [main-cam.c]
2011-06-23 Added code to test the uart interface on the motor board
2011-06-23 Added cam board uart test code
2011-06-23 Fully working motor test file
2011-06-24 cleaned up motor controller
2011-06-24 Added callback for the motor board uart
2011-06-24 Changed how the button module works
2011-06-24 Added soft-start to motor_test
2011-06-24 New seperated UART files.
2011-06-24 Copying interrupt defines
2011-06-24 Implemented the commander
    This module takes input from interruprts caused by the ir, uart and charger
    then passes the correct command back to the main loop for the state machine to
    eat for dinner.
    [charger.h, commander.c, ir.c, ir.h, main-motor.c]
2011-06-24 Updating to use new uart code
2011-06-24 Added get chat to dump char from uart to prevent lockup
    [uart_motor.h]
2011-06-24 Added interrupt_init
2011-06-24 Removed global interrupt enable
2011-06-25 Removed old uart code
2011-06-25 Fixed errors, I think it works now
    [debug.h]
2011-06-25 Missed one public function
    [keyboard.h]
2011-06-25 Added PMIC.STATUS to the interrupt error handling
    [main-cam.c, main-motor.c]
2011-06-26 Added some debug output to motor.c
2011-06-27 Added empty interrupt to reduce error messages
    [common.h, ir.c]
2011-06-27 Fixed debug output being intermingled
    [debug.c]
2011-06-27 Added uart debug initialization
2011-06-27 Some debug and atomicity fix
    [commander.c]
2011-06-27 Added pulldowns on uart receive pins
2011-06-27 Changed so motor controller does minimal changes
2011-06-27 No need to set movement if it doesn't change
    [main-motor.c]
2011-06-27 Added filtering of the debug output to a single module
2011-06-28 Initial camera commit - may be broken
    [camera.c, camera.h]
2011-06-28 deleted my scratchpad uart stuff
2011-06-29 Improved led display
2011-06-30 Added camera test module (for my use only)
2011-06-30 Fixed error in uart_init(): incorrect USART configured for camera. Was USARTD0, now USARTD1
    [uart_comms.c]
2011-06-30 My (benjamin) camera test thingee
2011-07-01 Fixing errors from last commit
    [debug.c, uart_common.h, uart_comms.c, uart_comms.h, uart_motor.h]
2011-07-07 Fixed bugs in comms board uart
    [cam_uart_test.c, uart_comms.c, uart_comms.h]
2011-07-07 Wrote a method to change UART baud rate.
2011-07-10 Removed cruft.
    [AT91.SchDoc, AT91SAM7S_Demo1.PrjPcb, Communications.SchDoc, Power.SchDoc, TopLevel.SchDoc, Treetap7c.PcbLib, Treetap7c.SCHLIB, UserInterface.SchDoc]
2011-07-11 Added chassis header
2011-07-11 Full new motor code
2011-07-11 servo driver partially completed
2011-07-11 Need the interrupt
2011-07-11 Added a simple camera bypass test file
2011-07-11 servo controller finished
2011-07-11 Working camera bypass code
2011-07-11 First attempt at filtering the bluetooth commands
2011-07-11 removed timer.star
2011-07-11 wheels aligned to centre'
2011-07-12 turn angle based on motor speed
2011-07-12 Changed to always reset direction after speed - wgl18
    [main-motor.c]
2011-07-12 Moved camera_bypass to main-cam
2011-07-12 Wrote the camera state functions
2011-07-12 Added the dastardly for the IR jamming
    [chassis.c, common.h, dastardly.c, dastardly.h, main-cam.c]
2011-07-12 got leds running at 38k
2011-07-12 Added code disable and enable dastardly IR leds
2011-07-12 got leds running at 33k
2011-07-12 Switched s and x for stop and back in the control
2011-07-12 display speed on led display
2011-07-12 stoped dasdidly interfering with camera
    [common.h]
2011-07-12 hopefully fixed pwm
2011-07-12 Fixing the percentage returned from camera
    [camera.py]
